simrunm/HandofGod/Website/HandofGod/images/mechanical_intro.jpg

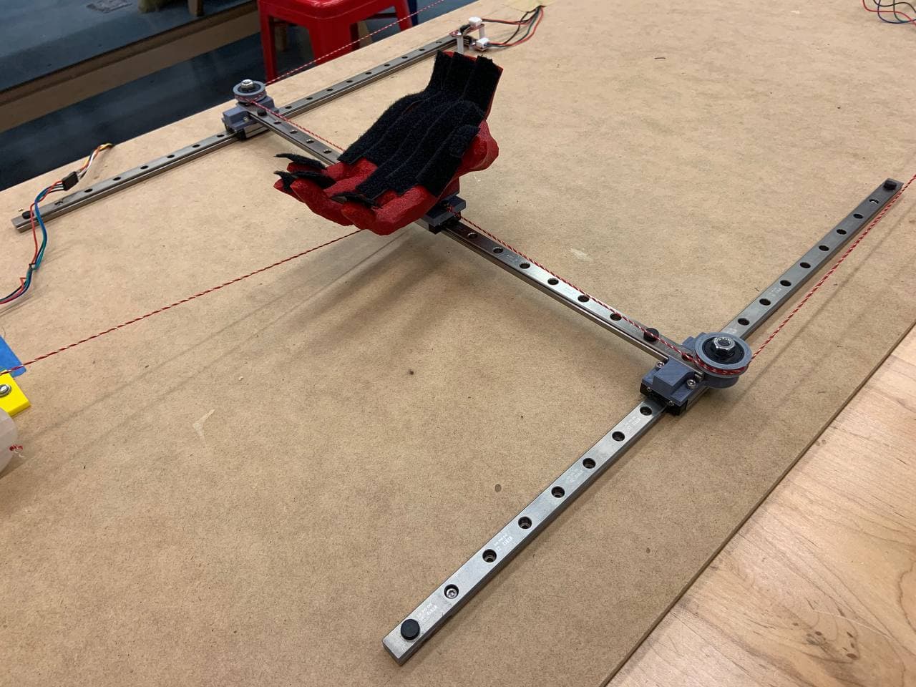
Website/HandofGod/images/mechanical_intro.jpg
