simrunm/HandofGod/Website/HandofGod/images/BillOfMaterials.png

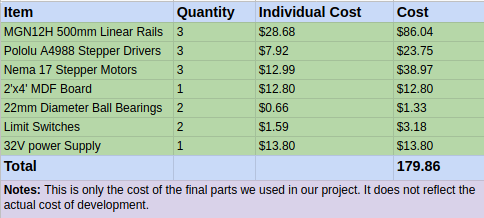
Website/HandofGod/images/BillOfMaterials.png
