simrunm/HandofGod/README.md

# HandofGod
Hand catches ball

To run trackObj.py, install openCV and numpy
