simrunm/HandofGod/hsv-colormap.png

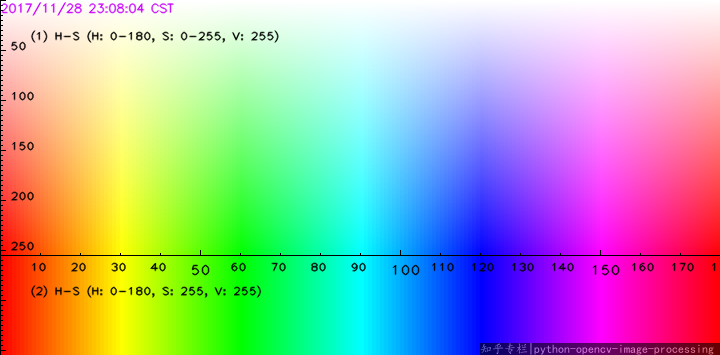
hsv-colormap.png
