simrunm/HandofGod/Website/HandofGod/assets/css/images/overlay.png

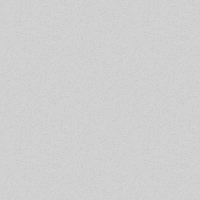
Website/HandofGod/assets/css/images/overlay.png
