simrunm/HandofGod/Website/HandofGod/images/both_cams.jpg

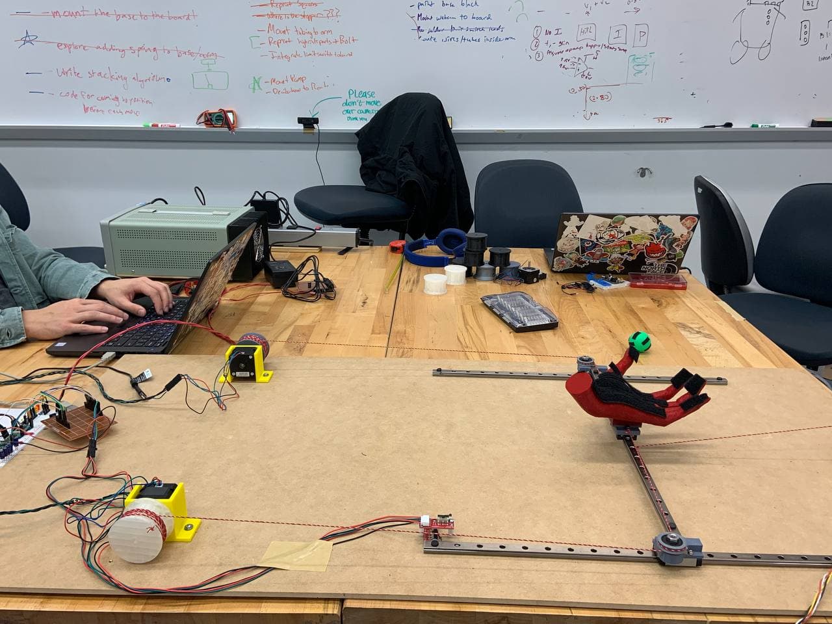
Website/HandofGod/images/both_cams.jpg
