simrunm/HandofGod/Website/HandofGod/images/camera_two.jpg

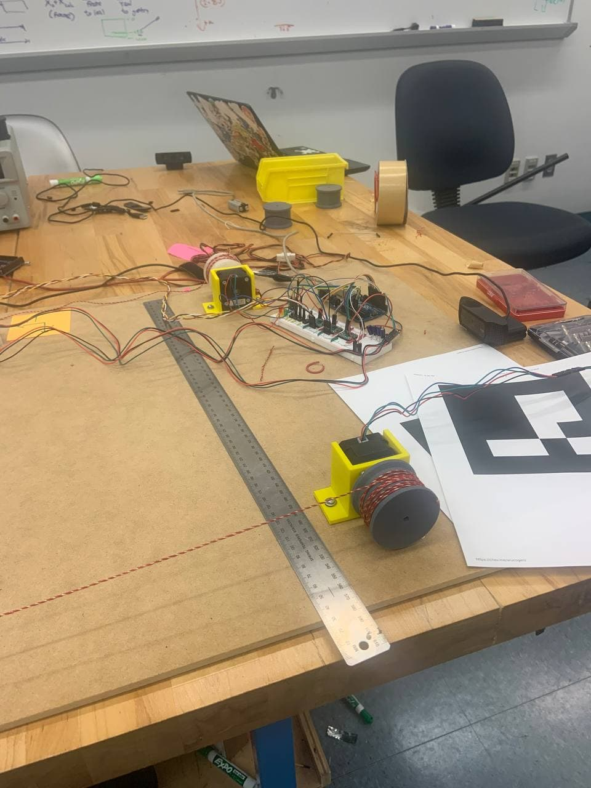
Website/HandofGod/images/camera_two.jpg
