simrunm/HandofGod/Website/HandofGod/images/Chris.JPG

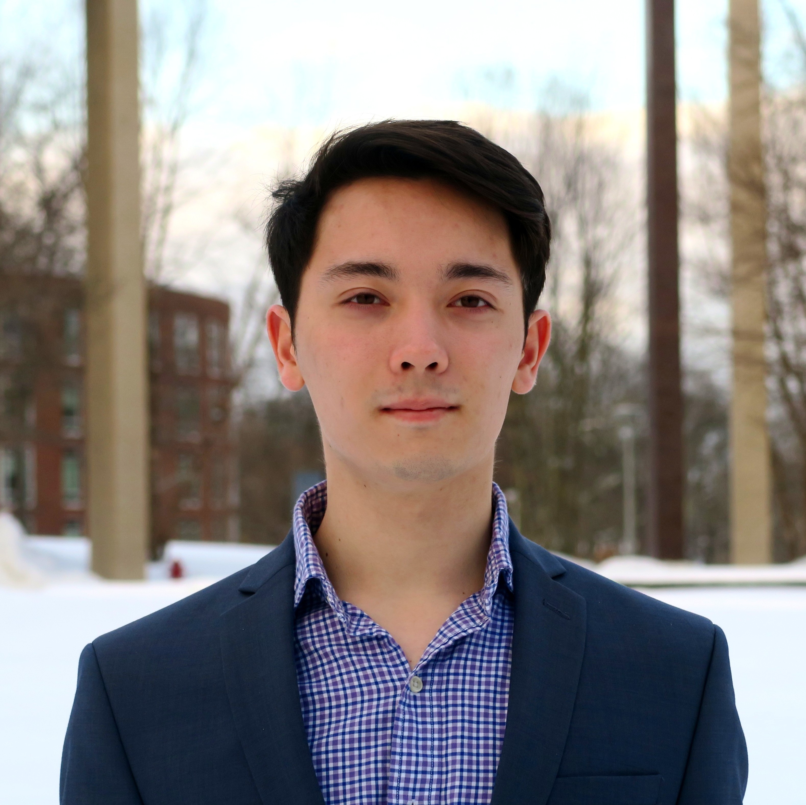
Website/HandofGod/images/Chris.JPG
