simrunm/HandofGod/Website/HandofGod/images/complete_frontview.jpg

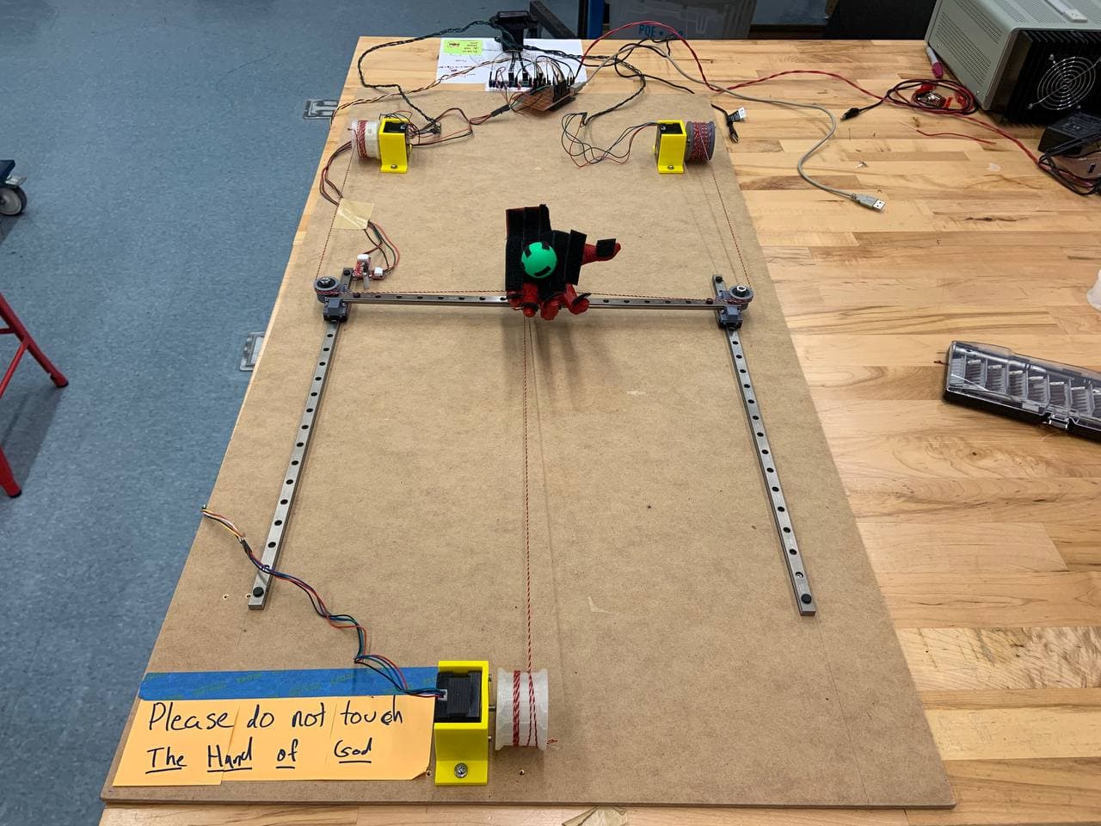
Website/HandofGod/images/complete_frontview.jpg
