simrunm/HandofGod/Website/HandofGod/images/electrical_intro.jpg

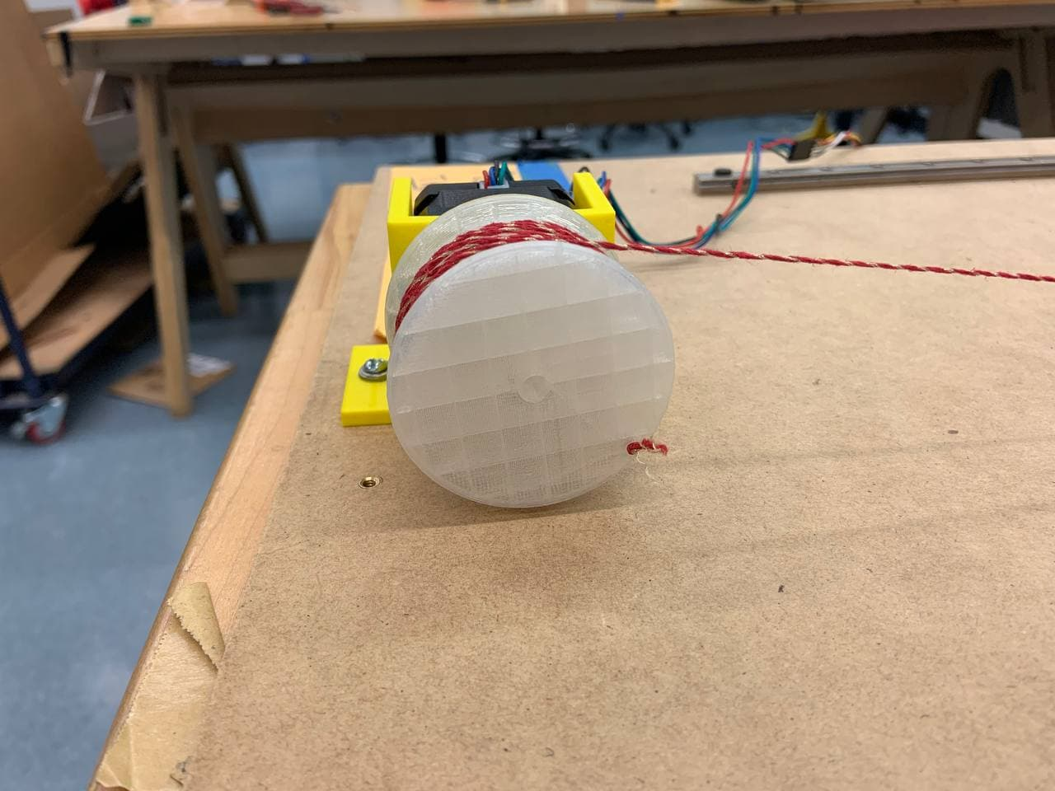
Website/HandofGod/images/electrical_intro.jpg
