simrunm/HandofGod/Website/HandofGod/images/elvis.png

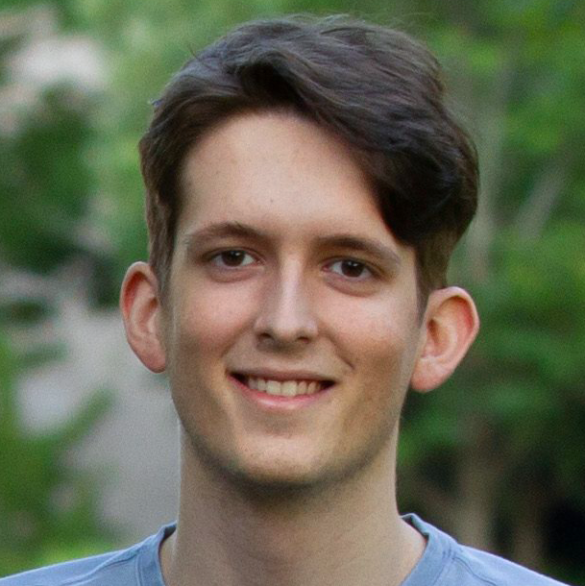
Website/HandofGod/images/elvis.png
