simrunm/HandofGod/Website/HandofGod/images/final_circuit.jpg

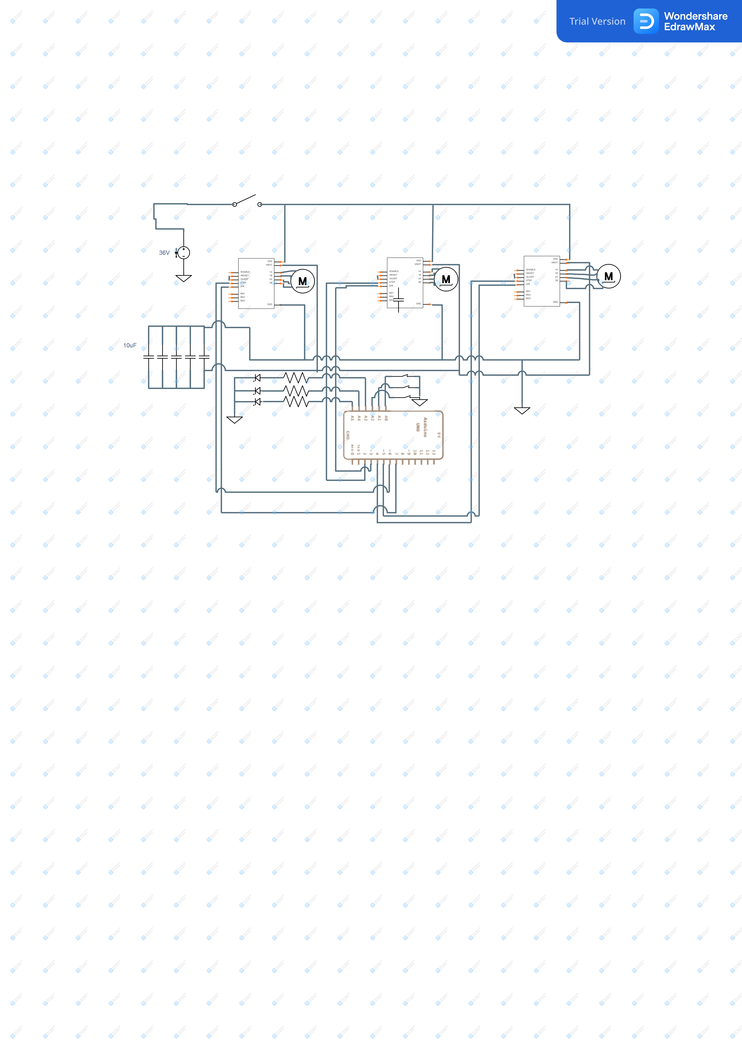
Website/HandofGod/images/final_circuit.jpg
