simrunm/HandofGod/Website/HandofGod/images/finalcircuit.png

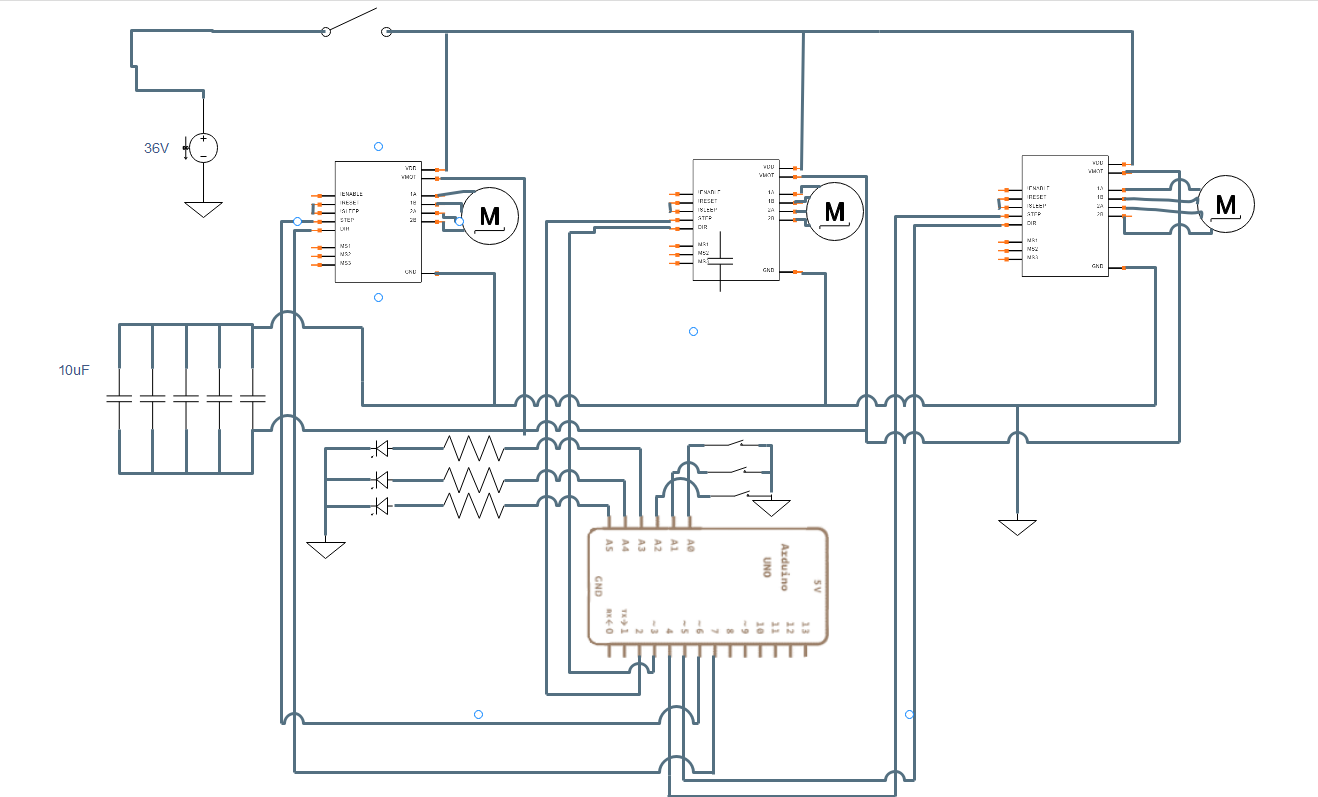
Website/HandofGod/images/finalcircuit.png
