simrunm/HandofGod/Website/HandofGod/images/firmware.png

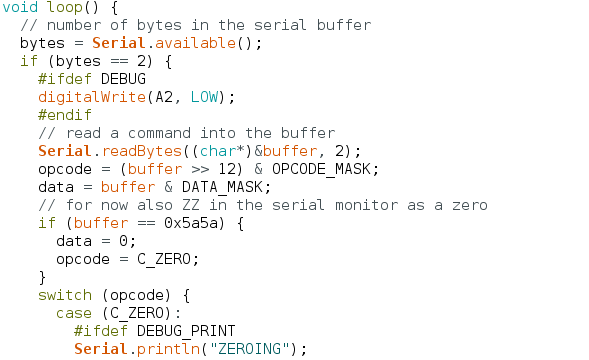
Website/HandofGod/images/firmware.png
