simrunm/HandofGod/Website/HandofGod/images/frontview_gantry.jpg

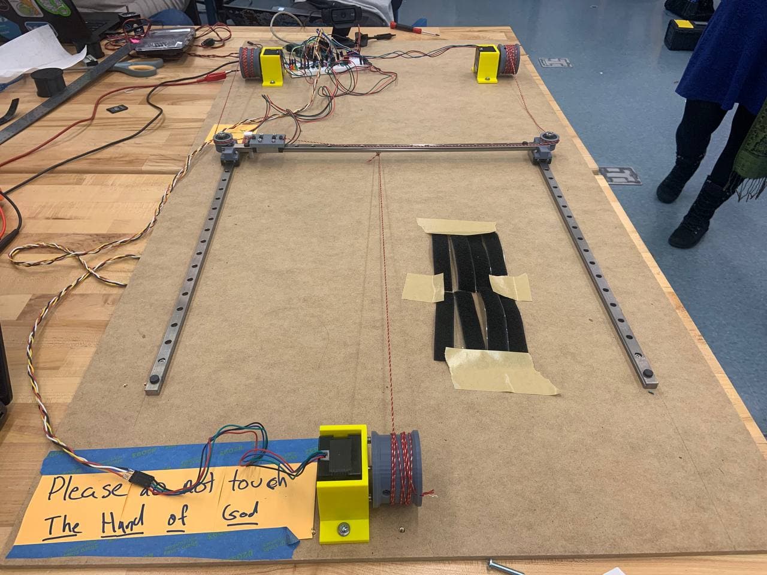
Website/HandofGod/images/frontview_gantry.jpg
