simrunm/HandofGod/Website/HandofGod/images/gantry_render_top.PNG

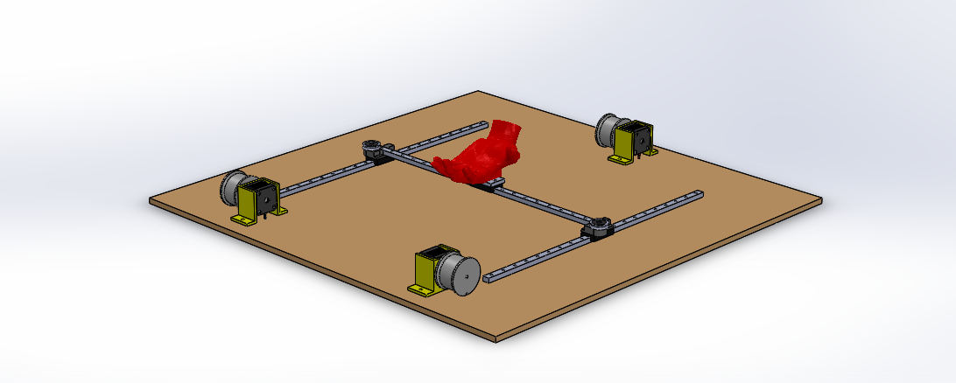
Website/HandofGod/images/gantry_render_top.PNG
