simrunm/HandofGod/Website/HandofGod/images/giphy.gif

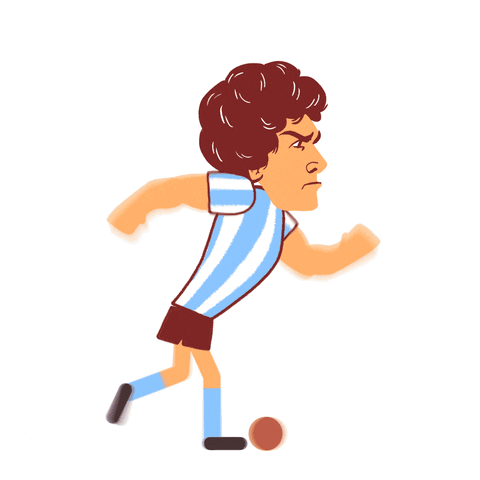
Website/HandofGod/images/giphy.gif
