simrunm/HandofGod/Website/HandofGod/images/hand.jpg

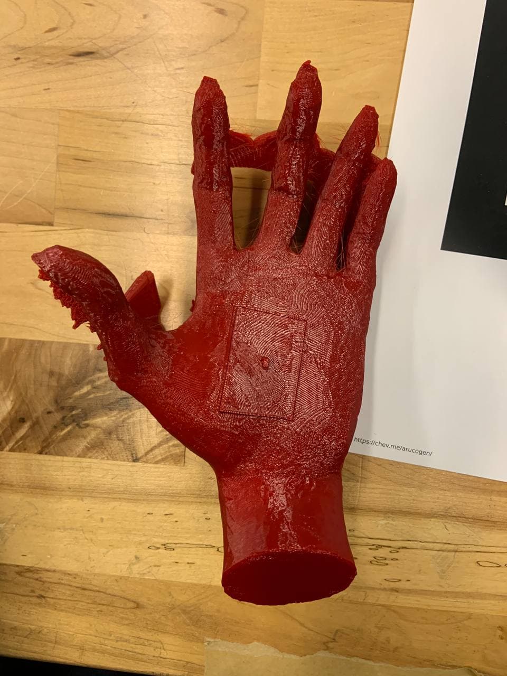
Website/HandofGod/images/hand.jpg
