simrunm/HandofGod/Website/HandofGod/images/handsideview.jpg

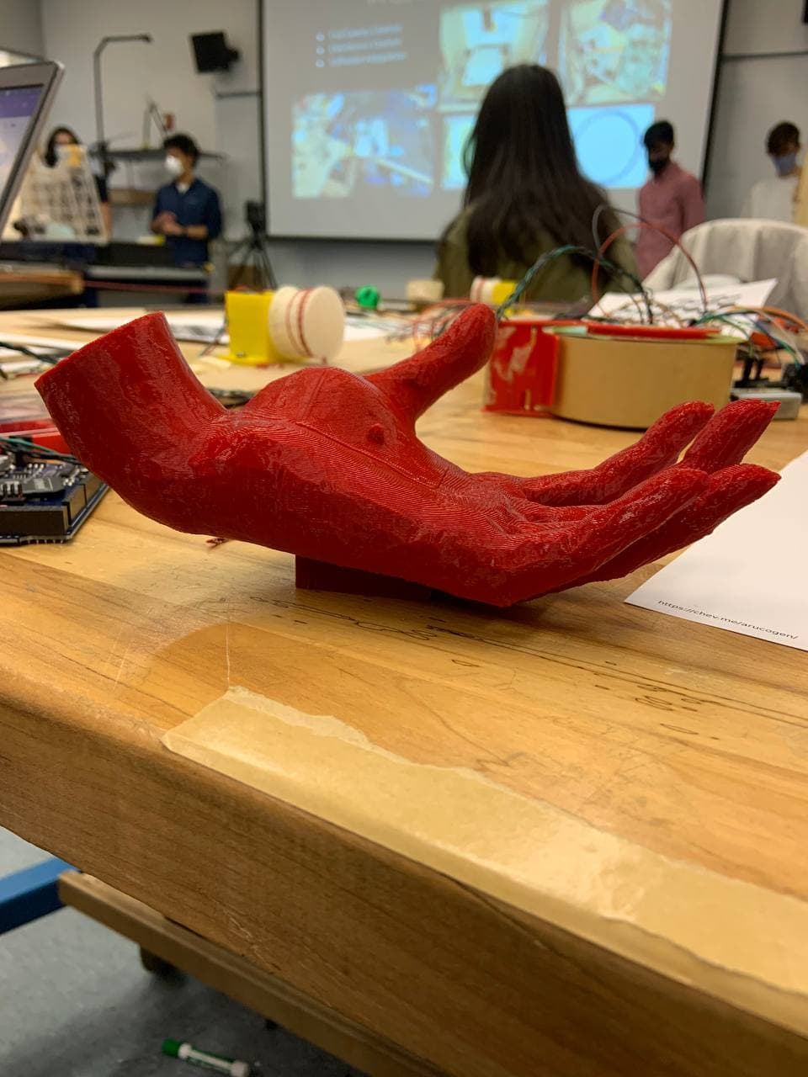
Website/HandofGod/images/handsideview.jpg
