simrunm/HandofGod/Website/HandofGod/images/maradona.jpg

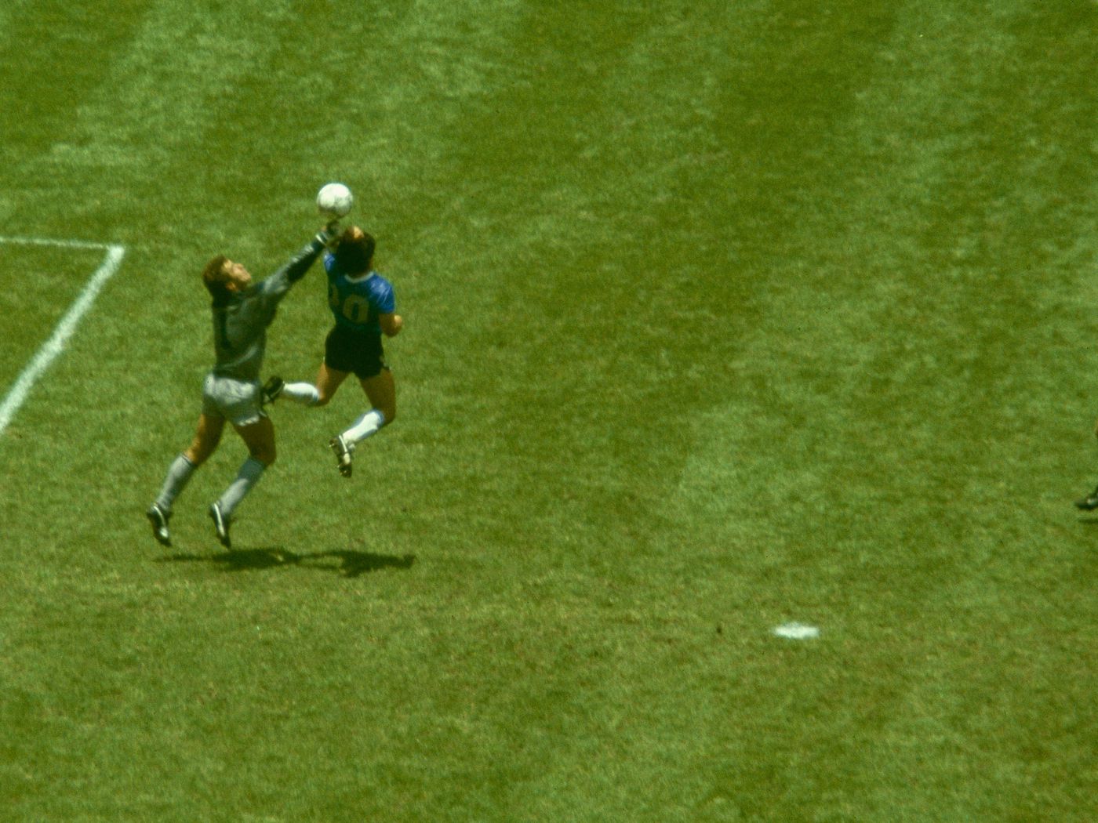
Website/HandofGod/images/maradona.jpg
