simrunm/HandofGod/Website/HandofGod/images/melody.jpg

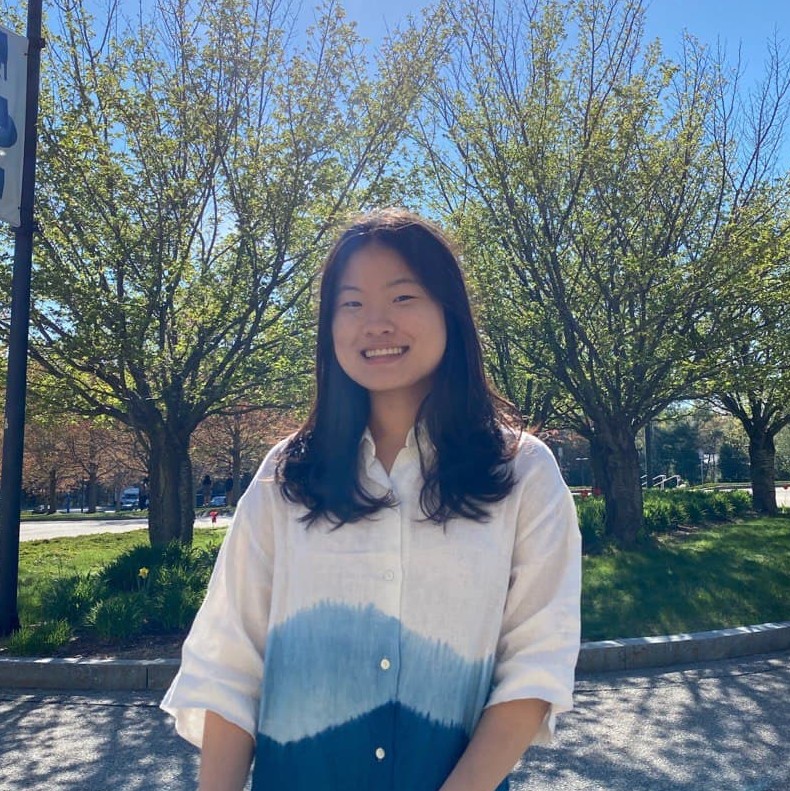
Website/HandofGod/images/melody.jpg
