simrunm/HandofGod/Website/HandofGod/images/opcodes.png

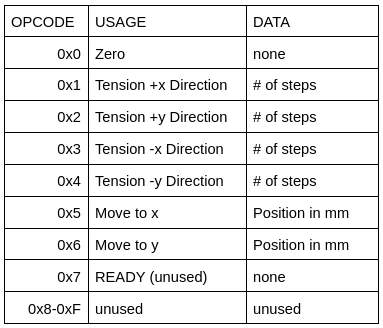
Website/HandofGod/images/opcodes.png
