simrunm/HandofGod/Website/HandofGod/images/patrick.jpg

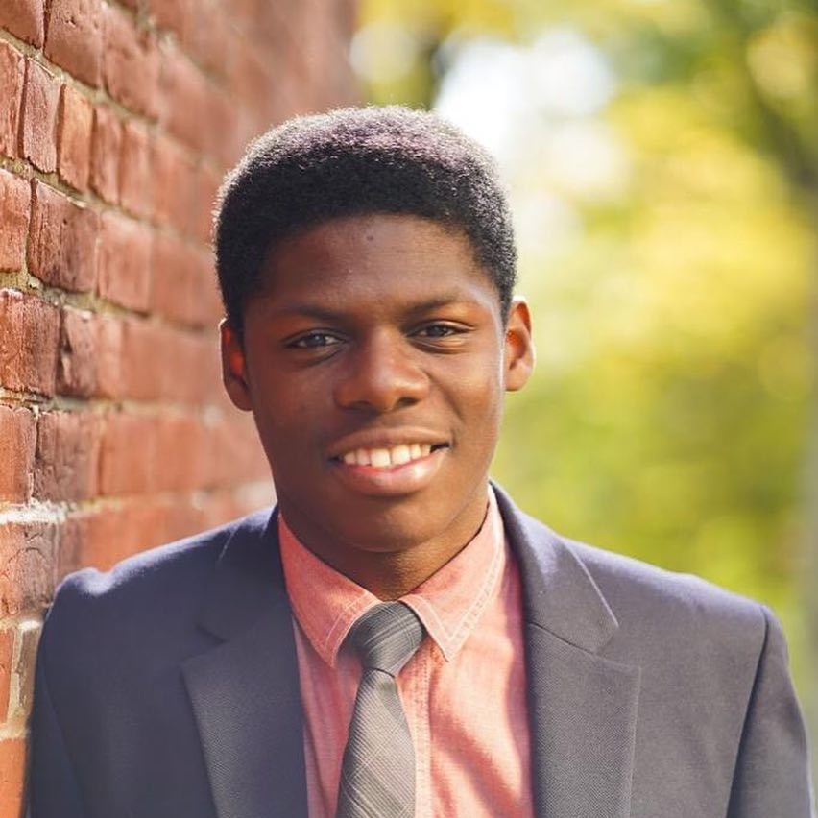
Website/HandofGod/images/patrick.jpg
