simrunm/HandofGod/Website/HandofGod/images/pic01.jpg

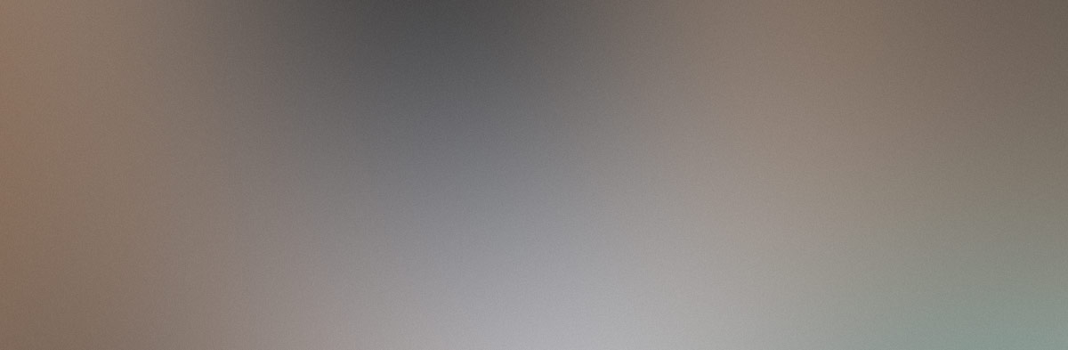
Website/HandofGod/images/pic01.jpg
