simrunm/HandofGod/Website/HandofGod/images/pic02.jpg

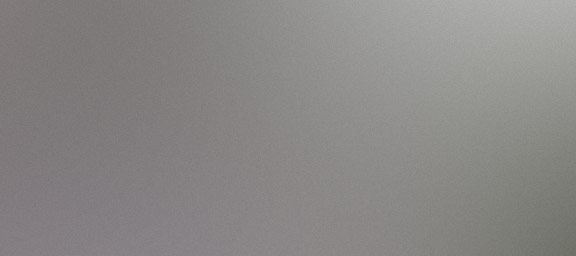
Website/HandofGod/images/pic02.jpg
