simrunm/HandofGod/Website/HandofGod/images/pic03.jpg

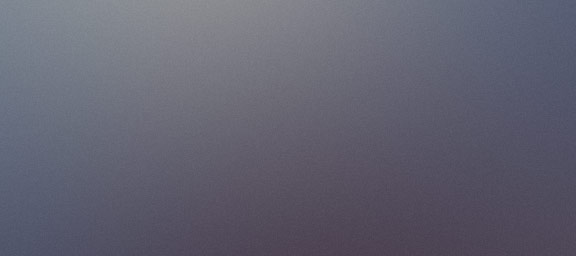
Website/HandofGod/images/pic03.jpg
