simrunm/HandofGod/Website/HandofGod/images/pic04.jpg

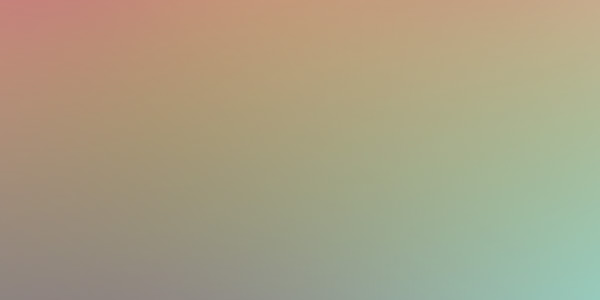
Website/HandofGod/images/pic04.jpg
