simrunm/HandofGod/Website/HandofGod/images/side_cam.jpg

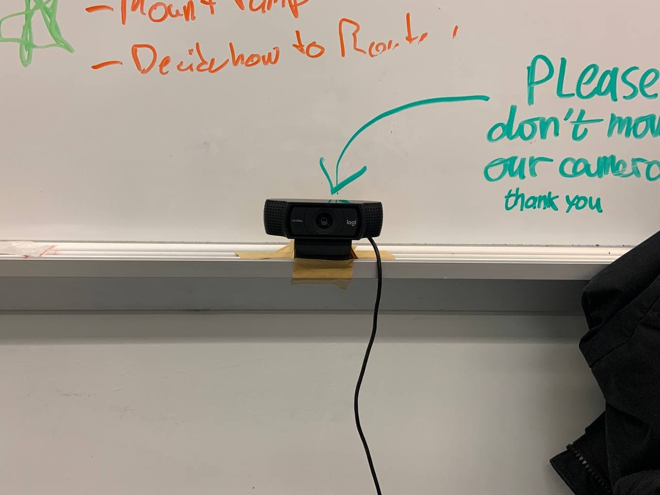
Website/HandofGod/images/side_cam.jpg
