simrunm/HandofGod/Website/HandofGod/images/side_view_2.jpg

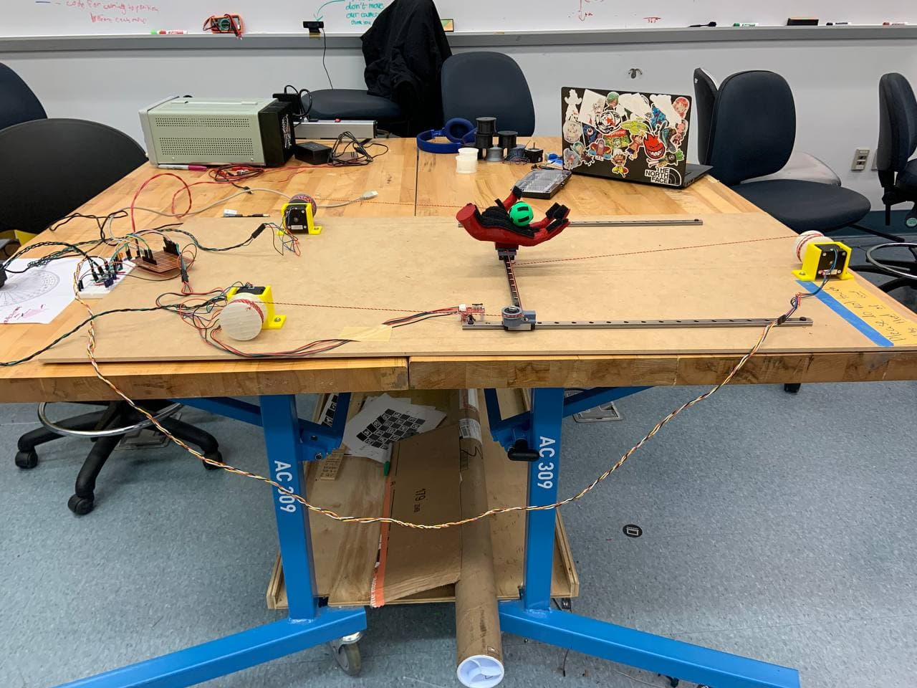
Website/HandofGod/images/side_view_2.jpg
