simrunm/HandofGod/Website/HandofGod/images/simrun.jpg

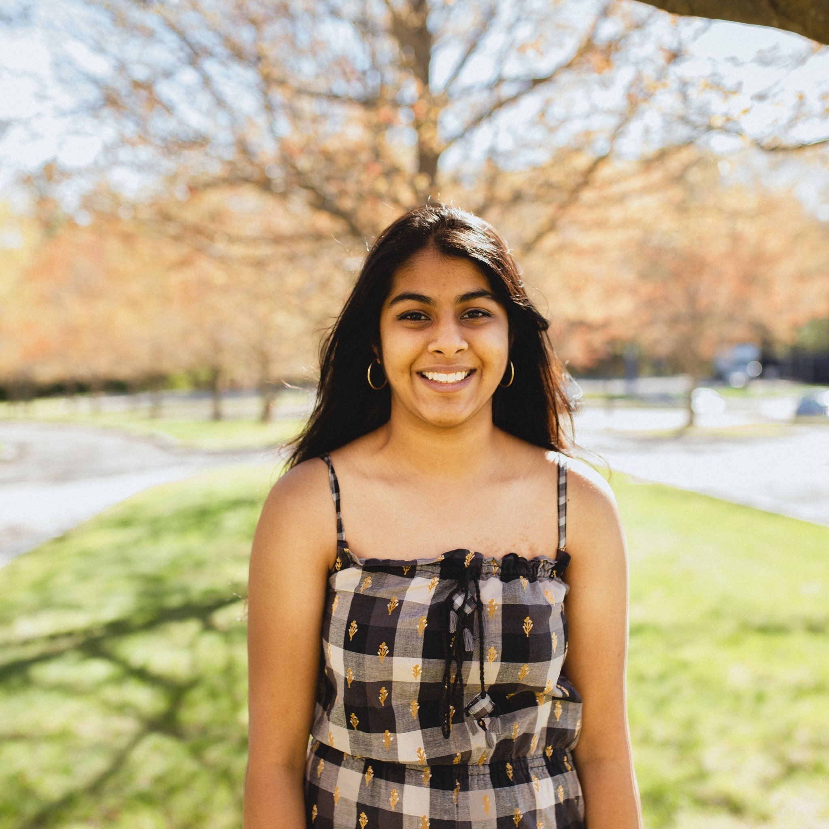
Website/HandofGod/images/simrun.jpg
