simrunm/HandofGod/Website/HandofGod/images/sketchdiagram.jpg

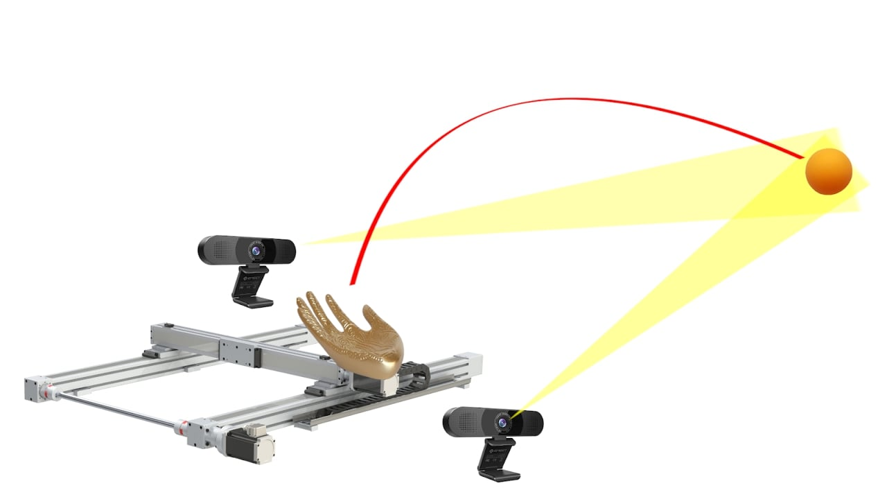
Website/HandofGod/images/sketchdiagram.jpg
