simrunm/HandofGod/Website/HandofGod/images/software_header.jpg

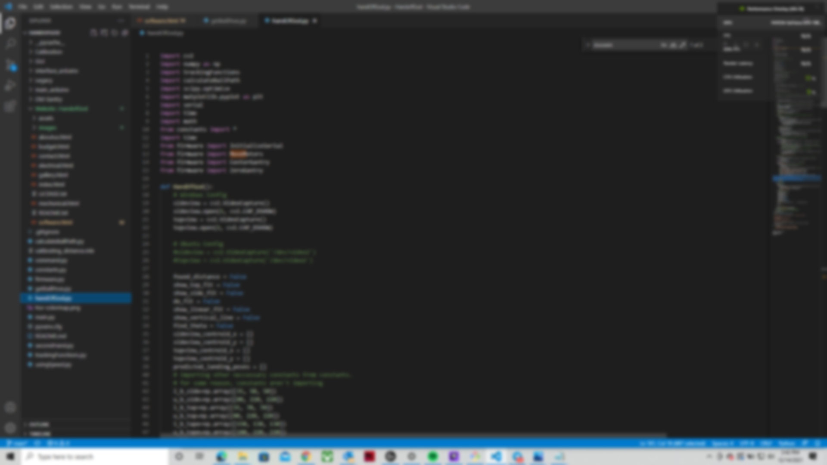
Website/HandofGod/images/software_header.jpg
