simrunm/HandofGod/Website/HandofGod/images/stepper_driver_signal.png

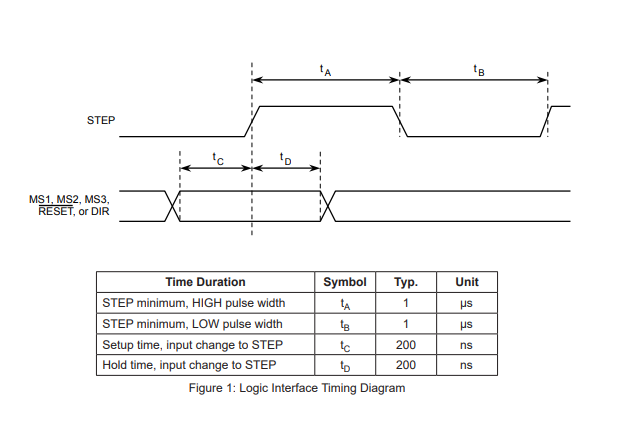
Website/HandofGod/images/stepper_driver_signal.png
