simrunm/HandofGod/Website/HandofGod/images/top_cam.jpg

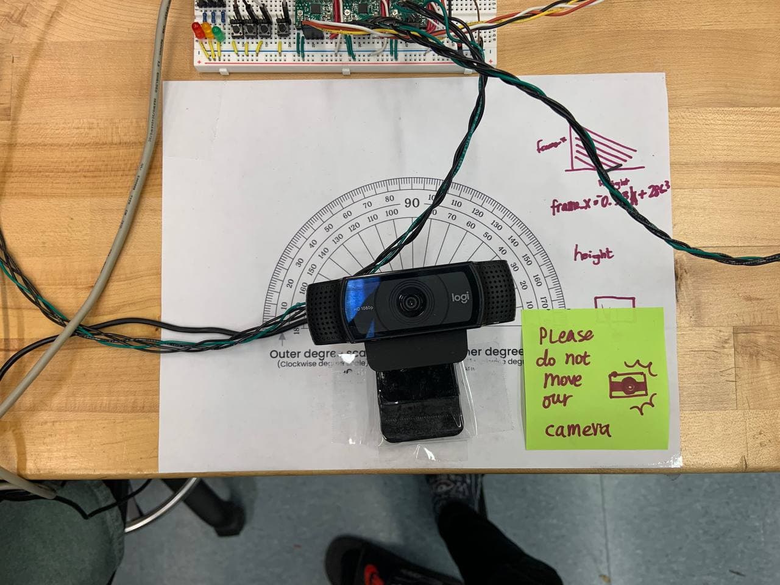
Website/HandofGod/images/top_cam.jpg
