simrunm/HandofGod/Website/HandofGod/images/topside_view.jpg

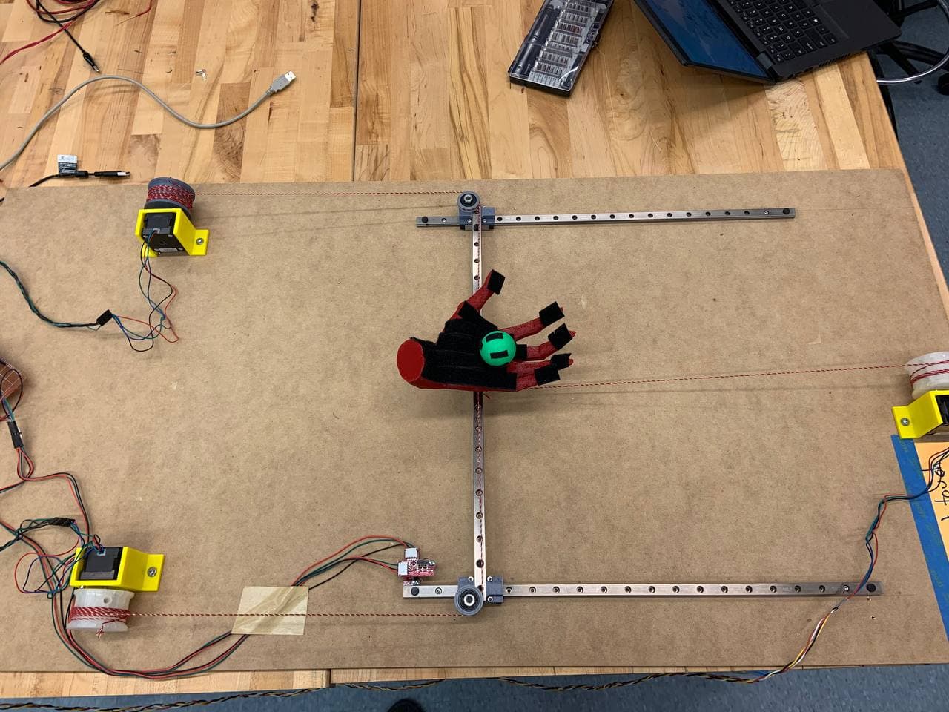
Website/HandofGod/images/topside_view.jpg
