simrunm/HandofGod/Website/HandofGod/images/website_front.png

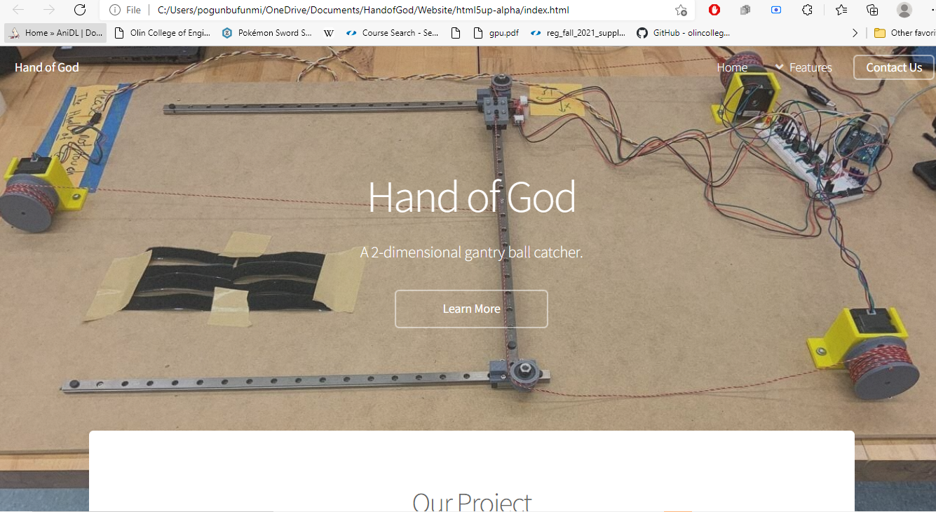
Website/HandofGod/images/website_front.png
