simrunm/HandofGod/Website/HandofGod/images/bom.jpg

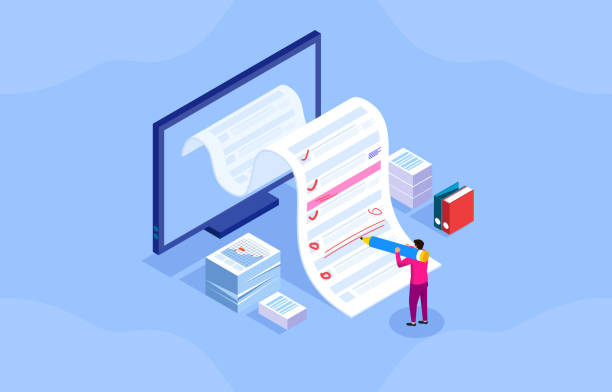
Website/HandofGod/images/bom.jpg
