simrunm/HandofGod/Website/HandofGod/images/bom_blurred.jpg

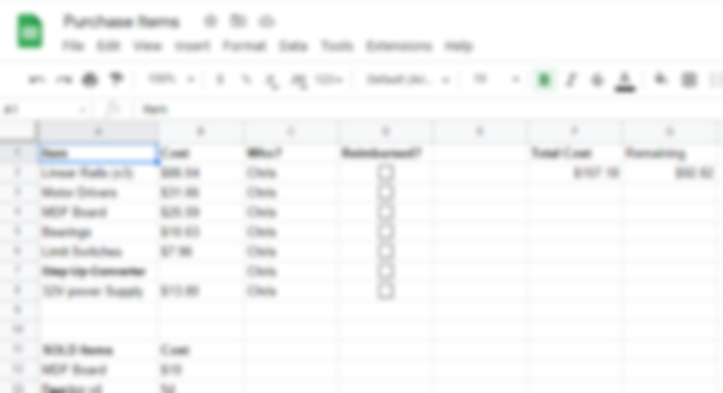
Website/HandofGod/images/bom_blurred.jpg
