simrunm/HandofGod/Website/HandofGod/images/bom_blurred.png

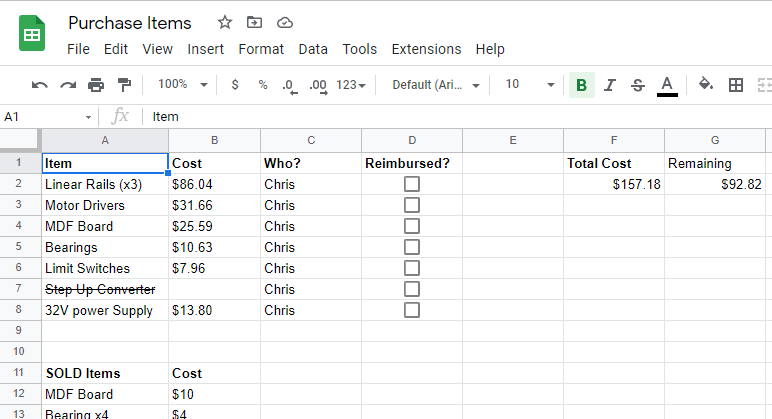
Website/HandofGod/images/bom_blurred.png
