simrunm/HandofGod/Calibration/charuco.png

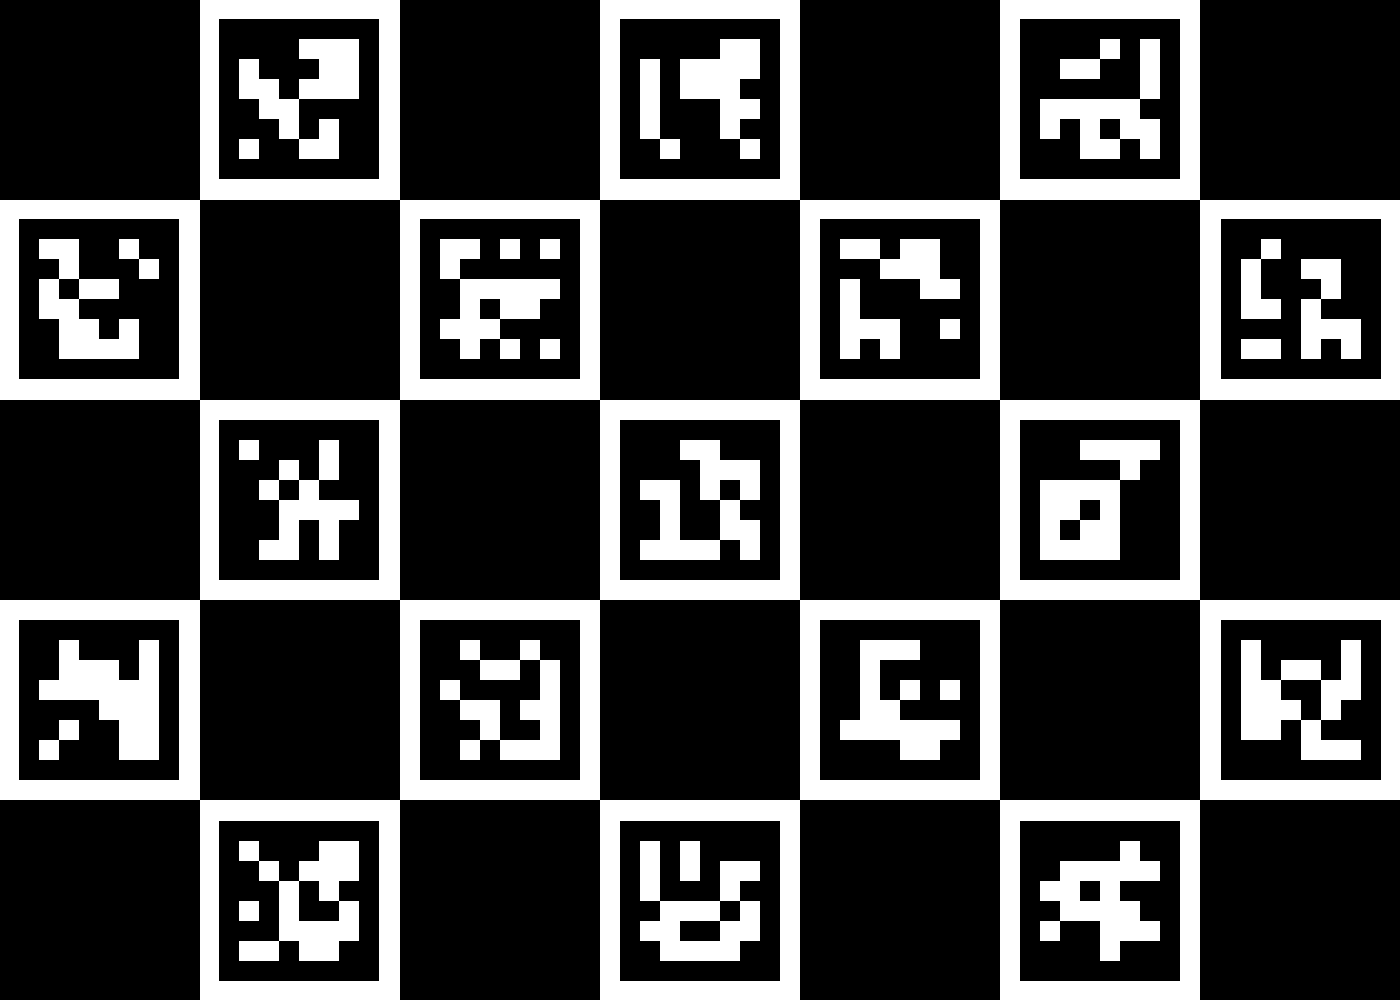
Calibration/charuco.png
