simrunm/HandofGod/(commit log)

2021-10-27 add object track code & colormap
2021-11-08 Add old motor speed calc code
2021-11-11 add tape calibration
2021-11-15 Motor Functionality Added
2021-11-15 integrate without threading
2021-11-18 feat: gantry zeroing procedure with manual stepper control
2021-11-27 add untested arduino code
2021-11-29 no thread test
2021-11-29 add ability to move gantry via serial
2021-12-05 fix: reverse motors for new hardware layout
    fix: packets on python end
    [command.py, main.py, main_arduino.ino]
2021-12-06 Spring cleaning
2021-12-06 add threading code
2021-12-06 Add threaded hand of god
2021-12-08 fixed speed issue by combining files
    [firmware.py, handOfGod.py]
2021-12-09 feat: begin exploring camera calibration
    [pyvenv.cfg]
2021-12-12 feat: support for tensioning
2021-12-14 Add demo mode for gantry
2021-12-14 fix: add power for endstops
2021-12-14 add circuit diagram to website
2021-12-14 Add new table to BOM page
2021-12-15 Update BOM to include motors
2021-12-15 Edit BOM cover image
