simrunm/HandofGod/Website/HandofGod/images/electrical.jpg

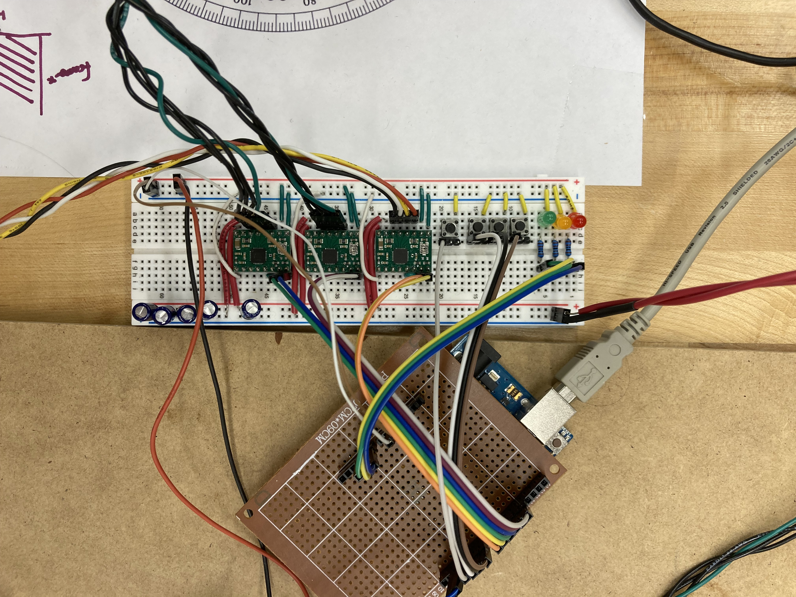
Website/HandofGod/images/electrical.jpg
